alexpaulzor/greenhousebot/docs/diagrams/connections.png

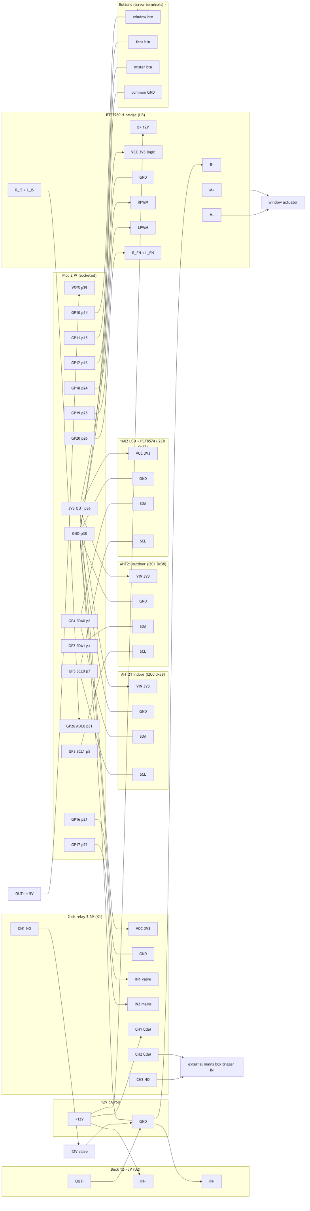
docs/diagrams/connections.png
