alexpaulzor/greenhousebot/docs/diagrams/kicad_board.png

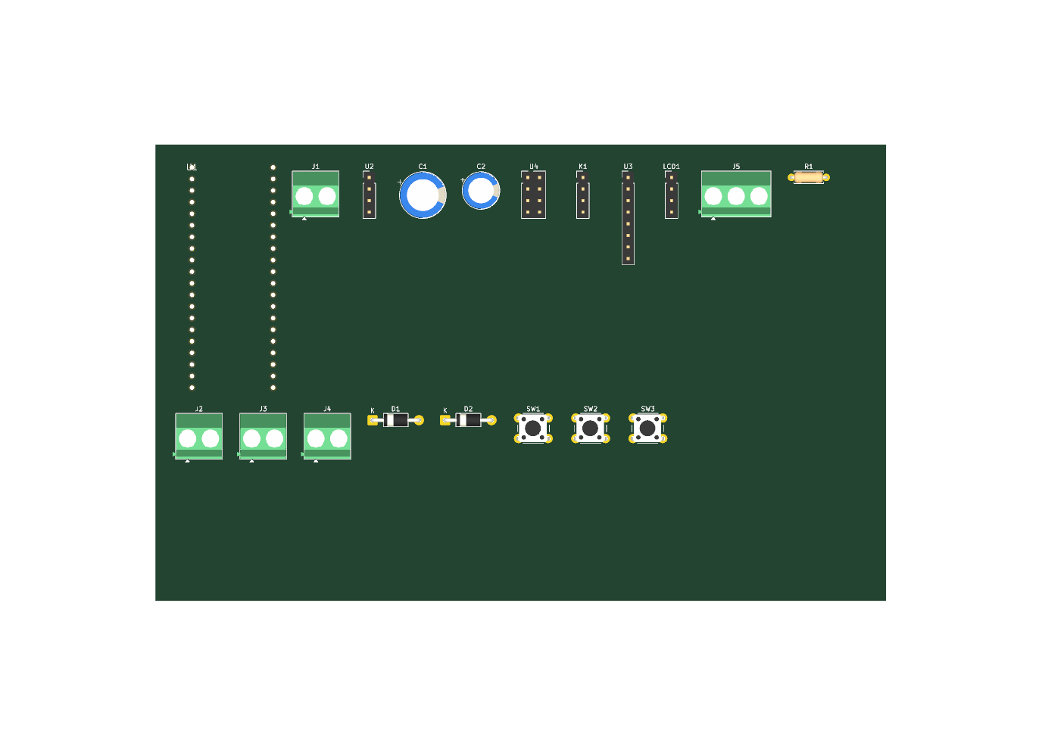
docs/diagrams/kicad_board.png
