alexpaulzor/greenhousebot/docs/diagrams/pcb_copper.png

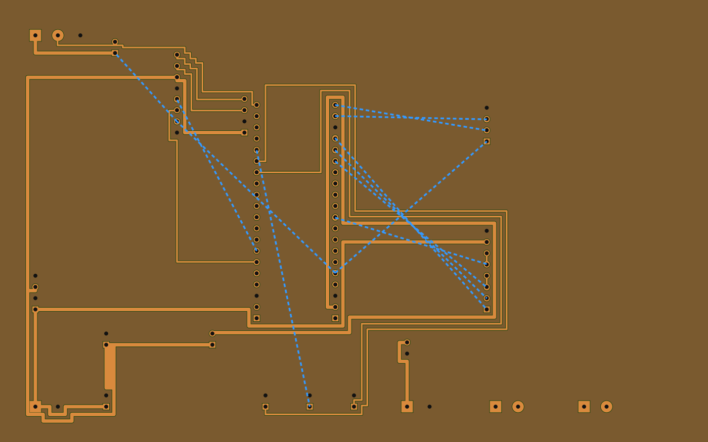
docs/diagrams/pcb_copper.png
