alexpaulzor/greenhousebot/docs/diagrams/pcb_layout.png

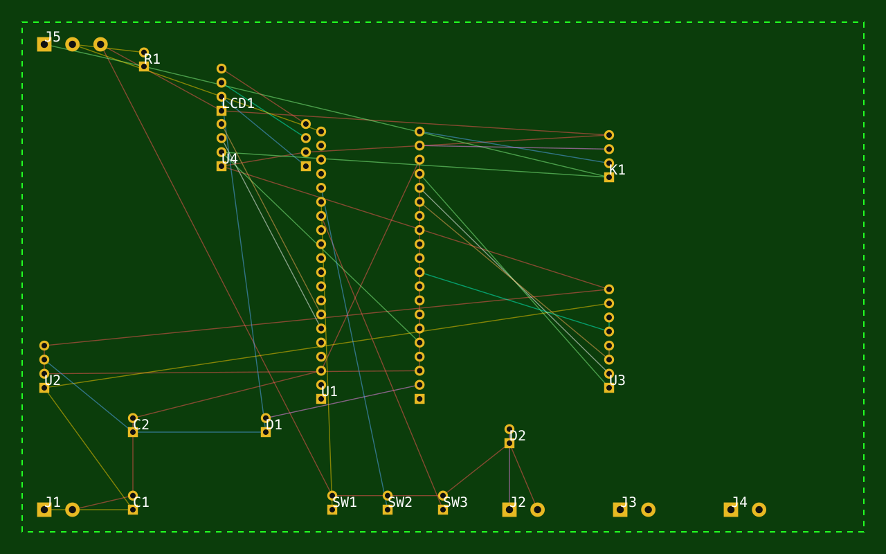
docs/diagrams/pcb_layout.png
