alexpaulzor/greenhousebot/kicad/greenhousebot.kicad_pcb

## KiCad design kicad/greenhousebot.kicad_pcb (2026-07-26)

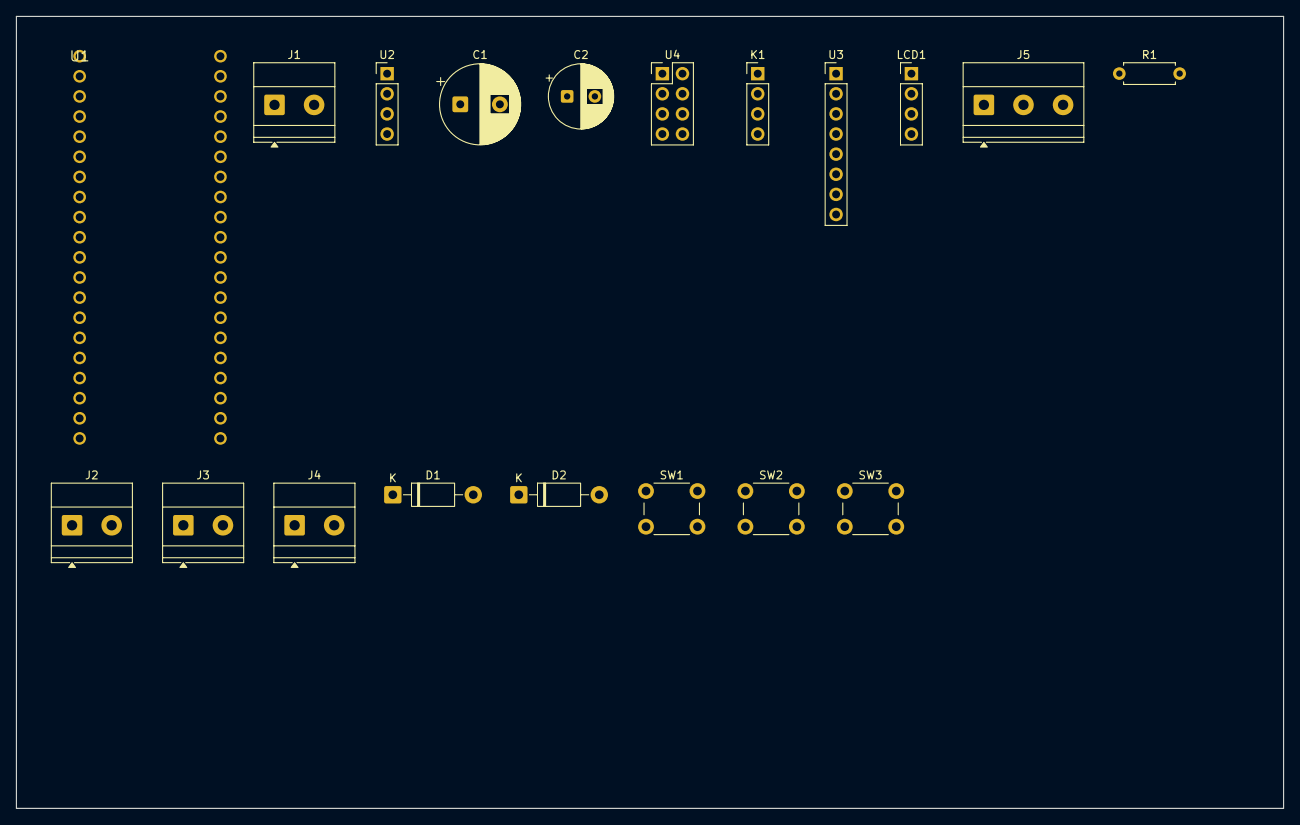
[picture p5: board greenhousebot.kicad_pcb from above]

Board: 2 copper layers, 160.0 x 100.0 mm, 19 parts (0 on the bottom side), 20 nets, no tracks yet.

Parts:
C1: 1000uF; CP_Radial_D10.0mm_P5.00mm
C2: 470uF; CP_Radial_D8.0mm_P3.50mm
D1: SS14; D_DO-41_SOD81_P10.16mm_Horizontal
D2: 1N4007; D_DO-41_SOD81_P10.16mm_Horizontal
J1: 12V_IN; TerminalBlock_Phoenix_MKDS-1,5-2_1x02_P5.00mm_Horizontal
J2: VALVE; TerminalBlock_Phoenix_MKDS-1,5-2_1x02_P5.00mm_Horizontal
J3: ACTUATOR; TerminalBlock_Phoenix_MKDS-1,5-2_1x02_P5.00mm_Horizontal
J4: MAINS_TRIG; TerminalBlock_Phoenix_MKDS-1,5-2_1x02_P5.00mm_Horizontal
J5: DHT22; TerminalBlock_Phoenix_MKDS-1,5-3_1x03_P5.00mm_Horizontal
K1: Relay2ch; PinHeader_1x04_P2.54mm_Vertical
LCD1: LCD_I2C; PinHeader_1x04_P2.54mm_Vertical
R1: 10k; R_Axial_DIN0207_L6.3mm_D2.5mm_P7.62mm_Horizontal
SW1: BTN-; SW_PUSH_6mm
SW2: BTN_OK; SW_PUSH_6mm
SW3: BTN+; SW_PUSH_6mm
U1: Pico_2W
U2: Buck_5V; PinHeader_1x04_P2.54mm_Vertical
U3: BTS7960; PinHeader_1x08_P2.54mm_Vertical
U4: BSS138_LS; PinHeader_2x04_P2.54mm_Vertical

Connections:
3V3: J5.1, K1.1, R1.1, U1.36, U4.2
5V_BUCK: C2.1, D1.2, LCD1.2, U2.3, U4.5
5V_VSYS: D1.1, U1.39
12V: C1.1, J1.1, U2.1, U3.7
BTN_MINUS: SW1.1, U1.15
BTN_OK: SW2.1, U1.16
BTN_PLUS: SW3.1, U1.14
DHT_DATA: J5.2, R1.2, U1.20
GND: C1.2, C2.2, D2.2, J1.2, J2.2, J5.3, K1.4, LCD1.1, SW1.2, SW2.2, SW3.2, U1.3, U1.23, U1.38, U2.2, U2.4, U3.8, U4.1, U4.6
HB_EN: U1.26, U3.3, U3.4
HB_IS: U1.31, U3.5, U3.6
HB_LPWM: U1.25, U3.2
HB_RPWM: U1.24, U3.1
RLY1_IN: K1.2, U1.21
RLY2_IN: K1.3, U1.22
SCL_3V3: U1.7, U4.4
SCL_5V: LCD1.4, U4.8
SDA_3V3: U1.6, U4.3
SDA_5V: LCD1.3, U4.7
VALVE_SW: D2.1, J2.1
