alexpaulzor/greenhousebot/(commit log)

2026-07-26 Design greenhouse controller: BOM, pinout, connectivity, solderless build
    Finalize the hardware design for the Pico 2 W greenhouse controller and pivot
    from a milled PCB to a solderless terminal-block build.
    Decisions captured:
    - Sensor: AHT21 (I2C 0x38); LCD run at 3.3V so the whole I2C bus is 3.3V and no
    level shifter is needed.
    - Relay: 2-ch native-3.3V module (valve + dry-contact mains trigger).
    - Power: 12V 5A PSU (confirmed) -> valve + BTS7960 + buck to 5.1V for Pico VSYS.
    - Mains never enters the box (external switched outlet box).
    - Buttons: panel-mount momentary via screw terminals (internal pull-ups).
    - No PCB: Pico screw-terminal expander + Wago lever-nuts. Nothing sensitive so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
    [greenhousebot.kicad_pcb]
2026-07-27 Add MicroPython firmware: manual-only greenhouse MVP
    Manual-first controller for the Pico 2 W. No automation yet — control.py is
    written + tested but parked for the future two-sensor rules.
    Features:
    - 3 buttons single-press TOGGLE window / fans / mister.
    - LCD shows indoor + outdoor temp/humidity and actuator status.
    - LAN web page mirrors readings + status with remote toggle buttons.
    - Scrape API: /status + /data (JSON), /data.csv + /events.csv.
    - Data logging: in-RAM ring buffers + bounded, rotating CSV files on flash
    (never grows without bound) capturing both sensors + every intervention.
    - WiFi from a gitignored secrets.py (secrets_example.py provided); NTP time.
    - Non-blocking coo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
2026-07-27 WIP: species-tuned automation rules (Maxillaria tenuifolia)
    Add the parked automation brain, tuned for Maxillaria tenuifolia in Walnut Creek.
    - docs/RULES.md: rule framework + seasonal setpoints + priority-tiered table.
    - control.py: dew-point-gated venting, growing/winter-rest setpoints, day/night,
    per-actuator tiered resolution. Temperature outranks humidity (heat/cold is the
    faster killer; humidity is cheaply recoverable via the mister) — only affects the
    window in a conflict; misting stays humidity-governed.
    - Timezone: NTP gives UTC; wifi.local_now() applies TZ_OFFSET_S so season/day-night
    use Walnut Creek local time. Log timestamps stay UTC for unambiguous scraping.
    - 18 con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
2026-07-27 Wire in automation toggle, log serving, and web timeline chart
    - Automation: control.py now runs in main.py behind a runtime /auto toggle
    (off by default). Auto tick uses local time for season/day-night, applies the
    Decision, and logs only actual changes (src=auto).
    - Web: POST /auto toggles automation; status now includes `auto`. The control
    page gains an automation button and a dependency-free <canvas> timeline chart:
    temp in/out + humidity in/out lines (dual axis) with fan/window/mister state
    bars beneath. Verified rendering headless (Chrome) with mock data.
    - Data: samples now carry actuator state (fans,mist,win as 1/0) so the chart and
    the scrape dataset are self-contained.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
2026-07-27 Add desktop simulator; tag manual actions as src=manual
    Log source taxonomy is now auto / web / manual:
    - Physical button actuations log as src="manual" (was "button").
    - Web page actuations log as src="web"; automation as src="auto".
    - Extract Actions into firmware/actions.py (hardware-free) so both main.py and
    the simulator drive the exact same actuation + logging logic.
    Simulator (sim/simulate.py): run the real web UI locally with fake sensors +
    generated history — no Pico. Serves the actual webapp.route over http.server,
    with fake actuators that respond to commands and a background thread advancing a
    stable simulated environment (sub-stepped 60s relaxation) and running the control
    r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
2026-07-27 Display temperatures in Fahrenheit by default
    Add TEMP_UNIT (default "F") as a DISPLAY-only setting. Internals stay Celsius:
    sensors, dew-point math, and the control rules are unchanged, so nothing is
    re-tuned. Only human-facing readouts convert:
    - LCD converts temps to the configured unit.
    - /status advertises `unit`; temp values stay Celsius and the web client converts.
    - Web readings + chart temp axis render in the display unit (F: 32/50/68/86/104).
    - /data JSON and CSV exports stay Celsius — one canonical unit for scraping.
    Verified in the simulator (headless Chrome): readings 74.8F, chart axis in F, data
    still Celsius. 44 tests passing (webapp gains a unit/canonical-Celsius test).
    C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
2026-07-27 Add per-component wiring section; harden long outdoor I2C run + fan SSR chain
    WIRING.md now has a "by component" view (every wire per device with conductor
    suggestions) alongside the existing by-bus view.
    Long outdoor sensor run (>3 m):
    - Use twisted pair (Cat5e); capacitance, not gauge, is the limit (~45 pF/m vs the
    ~400 pF I2C budget). Thicker wire doesn't help.
    - External 2.2 kOhm pull-ups at the Pico end (internal ones too weak for the line).
    - I2C1 clocked at 50 kHz (new I2C1_FREQ) for margin. P82B715 extender noted as a
    fallback for longer runs.
    Fans (two-stage relay chain, per builder's design): 3V3 relay CH2 dry-contact
    switches a 12 V signal over the long run to a LOCAL AC SSR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
    [config.py, main.py]
2026-07-28 Add LCD+button bezel CAD and single-tool CNC CAM
    Flat 3mm-plastic front panel carrying the 1602 LCD + 3 buttons, plus the
    OpenBeam 1515 frame model. Generates spindle G-code via the code-first
    cnc_vibes CAM lib (no FreeCAD).
    - lcd_button_bezel.scad: parametric geometry, source of truth
    - bezel_cam.py: composes pocket_mill + profile_cut_with_tabs into one file
    - README.md: measure -> generate -> validate/preview/preflight runbook
    All holes are >= 1/8" so the whole job runs on a single 1/8" 2-flute with
    no tool changes (sub-1/8" bits are many-fluted and melt plastic). Generated
    gcode is regenerable, so cad/build/ is gitignored.
    [lcd_button_bezel.scad]
2026-07-28 Emit one continuous spindle program (fix CAMotics errors)
    Each cam.py op is a standalone program with its own $32/G21/M3 preamble and
    M5/return-to-origin footer. Concatenating them restarted the spindle and
    rapided home between every hole, and the bare `$32=` GRBL *setting* (not
    valid RS-274) made CAMotics throw parse errors on every section.
    Now compose one program: a single validator-clean preamble (;HEAD/;MATERIAL/
    ;TOOL markers, G21/G90/G94, one M3), each op stripped to motion via _strip_op
    (keeps its safe-Z retract so the tool still lifts between holes), and one
    footer. $32=0 is documented as a machine-side setup step, not emitted. The
    two-tool fallback inserts an M0 pause + updated ;T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
2026-08-04 Add web-adjustable settings store (WIP checkpoint)
    Promote the behavioural tuning constants (seasonal setpoints, safety limits,
    vent/mist timings, schedule hours, display unit — 24 knobs) into a pure,
    web-editable, reboot-persistent store.
    - settings.py: one ordered SPEC list is the single source of truth for
    defaults (pulled from config.py/control.py, not duplicated), validation
    (type + range/choices, clamped), and web UI order. update() applies only
    keys that actually change; low/high pairs are order-guarded (e.g.
    day_start < night_start, so a fat-finger can't make it "always night" and
    disarm daytime cooling). save() is atomic (temp file + rename).
    - control.py: reads setpoin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
    [actions.py, buttons.py, config.py, control.py, datalog.py, main.py, settings.py]
2026-08-04 Docs: settings feature + fan-split/gate doc-rot fixes (WIP checkpoint)
    - README / firmware/README: document web-adjustable settings (routes, panel,
    live + atomic-persist behaviour, order guards), bump host-test count to 68.
    - RULES.md: note the setpoints/timings are web-adjustable at runtime.
    - Regenerate hardware docs (BOM, CONNECTIONS, PINOUT, WIRING, diagrams) for the
    vent/circ fan split + vent temperature gate; mark the old circuit superseded.
    - docs/notes/settings-work.md: design decisions, batched open questions, and the
    adversarial-review findings and their resolutions.
